LaboratorioGluon/Icaro/Modules/CamBoard/Doc/CameraBoard.md

# Camera Board

Tarjeta diseñada para capturar, envíar y guardar imágenes.
