LaboratorioGluon/Icaro/Modules/SensorBoard/Doc/SensorBoard.md

# Sensor Board

Tarjeta encargada de recoger datos de los sensores y telemetría

## Funcionalidad

## Diseño
