LaboratorioGluon/Icaro/Docs/Images/IMS.png

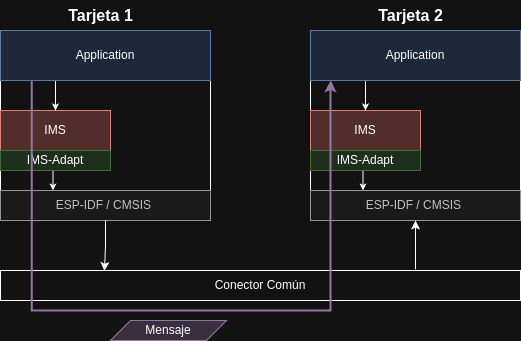
Docs/Images/IMS.png
