LaboratorioGluon/Icaro/Docs/Images/Parche_Icaro_alpha.png

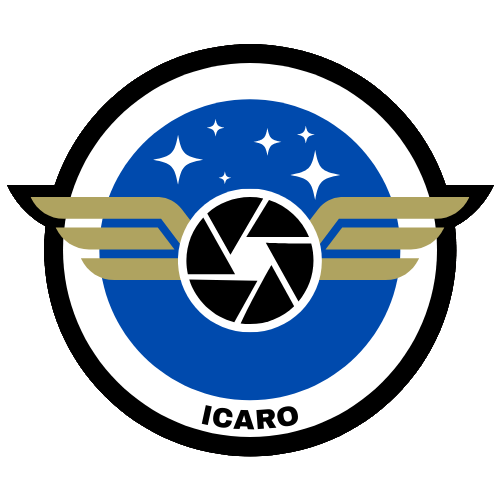
Docs/Images/Parche_Icaro_alpha.png
