LaboratorioGluon/Icaro/Modules/SupplyBoard/PCB/SupplyBoard/SupplyBoard.pdf

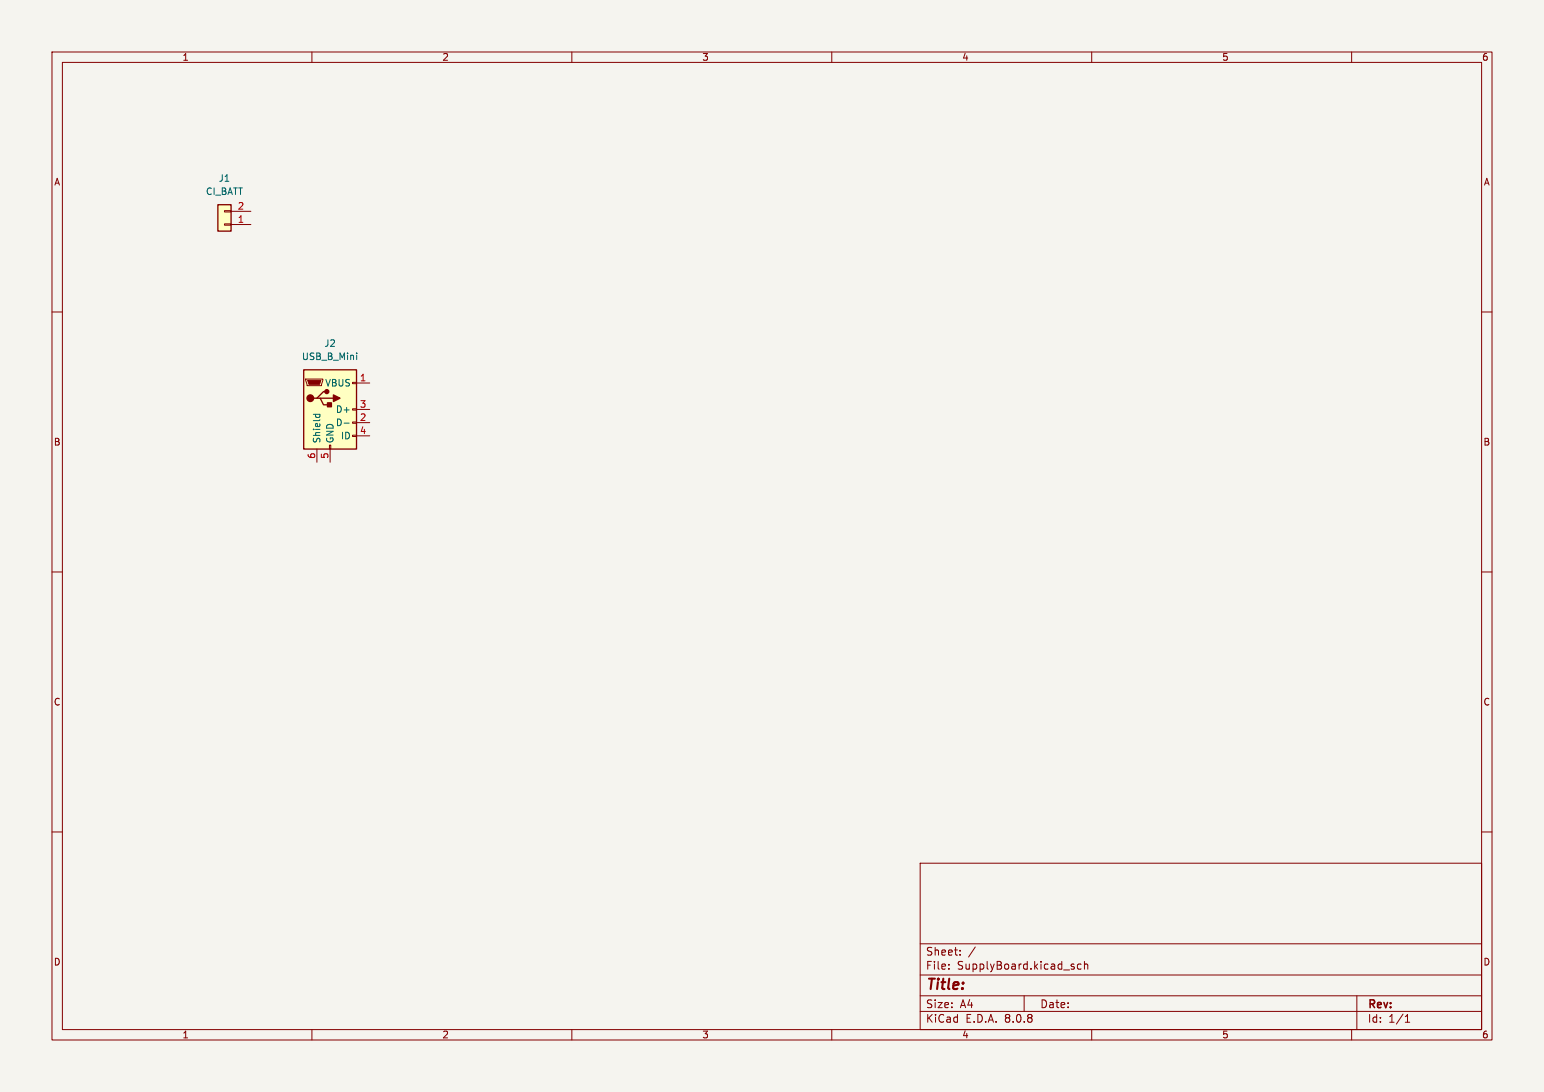
[picture p4: page 1]

Id: 1/1 Title: File: SupplyBoard.kicad_sch Sheet: /
