LaboratorioGluon/Icaro/Modules/SupplyBoard/PCB/SupplyBoard/SupplyBoard.kicad_pcb

## KiCad design Modules/SupplyBoard/PCB/SupplyBoard/SupplyBoard.kicad_pcb (2025-01-26)

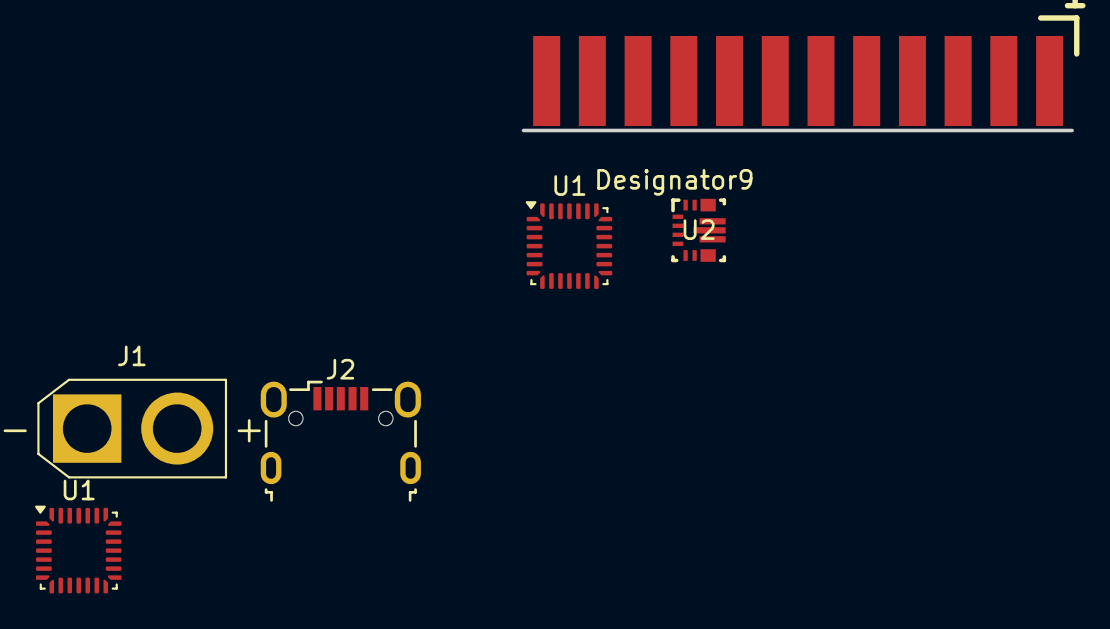
[picture p5: board SupplyBoard.kicad_pcb from above]

Board: 2 copper layers, 6 parts (0 on the bottom side), 5 nets, no tracks yet.

Parts:
J1: CI_BATT; AMASS_XT30U-F_1x02_P5.0mm_Vertical
J2: USB_B_Mini; USB_Micro-B_Wuerth_629105150521
J3: CIO_MAIN_CONNECTOR; Connector_Icaro_Edge_tarjeta
U1, U1#2: STM32L031G6Ux; QFN-28_4x4mm_P0.5mm
U2: TPS63070; RNM0015A

Connections:
+3.3V: J3.6 (3V3), U1.1 (VDD)
/BATT_BYPASS: J3.1 (BYPASS), J3.2 (BYPASS)
/I2C0_SDA: J3.7 (SDA_0), J3.9 (SCL_0)
GND: J1.1, J3.3 (GND), J3.4 (GND), J3.15 (GND), J3.16 (GND), U1.16 (VSS), U1.28 (VSS)
unnamed: U1#2.16 (VSS), U1#2.28 (VSS)
