LaboratorioGluon/Icaro/(threads)

Thread 1 (2025-01-20):

Elegir conector para juntar las tarjetas.

LaboratorioGluon, 2025-01-20:
Hay que elegir un conector que nos permita apilar las tarjetas una encima de otra tipo sandwich.

Ejemplo: https://www.researchgate.net/figure/Standard-2U-CubeSat-diagram-CubeSats-are-small-scale-satellites-composed-of-several_fig1_331595385

Como aún no sabemos cuantos pines necesitamos, buscar la referencia para 8-10 pines

Necesario:
- Part number en lcsc
- Precio

sergivv, 2025-01-20:
Hola,
Yo pensé en estos:
LCSC Part: C169817
Precio: 0,84$

En lugar de montar las placas en sandwich como en la foto, se haría una placa con distintos "puertos" (como una placa base del ordenador) y se pincharían ahí los módulos.
En las placas auxiliares se puede poner un sistema de tuercas para amarrar bien la placa a la base. (a ver si consigo una foto).
También en las placas auxiliares y en la que lleve el ESP32 se pude interponer un minipuente en cada pin para activar solo los que necesitas (con un puente de estaño)

LaboratorioGluon, 2025-01-20:
Entiendo que dices algo como esto: https://www.researchgate.net/figure/The-picture-above-shows-an-early-version-of-the-backplane-with-the-OBC-mounted_fig4_269389876

Se usa mucho en aviónica y tal, el tener como una placa con los conectores, y el resto se enganchan a ella. De hecho podríamos usar conectores PCIe 1x o parecidos. He encontrado este:

C5173289
0.34€/u
https://www.lcsc.com/product-detail/Edgeboard-Connectors_WingTAT-ED10BGFBK_C5173289.html

La única pega por decir algo, es que las placas no se puede reutilizar solas. Si ponemos un pinheader normal, es más fácil utilizar la placa de sensores en otro proyecto. Pero aún así, me mola la idea

Algo como esto, aprox... muy aprox
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

sergivv, 2025-01-20:
Efectivamente me refería a como está en el enlace. Pero a mayores se podría poner unos tornillos que aseguren la placa.

Intentaré sacar una fotos a unas placas que hicieron en mi empresa, no lleva los pines como los que indique.
Lleva otros que son con muelle pero son carillos. Lo bueno es que en la placa base no lleva nada, solo contactos del cobre.

LaboratorioGluon, 2025-01-21:
Se usará McGyver en el lateral con pin header estándar de 2.54mm

Closed 2025-01-21.

Thread 2 (2025-01-20):

Elegir pinout del conector general para el tipo sandwich

LaboratorioGluon, 2025-01-20:
Hay que tener una idea de cómo organizamos el pinout del connector común a todas las tarjetas. Necesitamos que cualquier otra tarjeta se pueda pinchar encima, así que lo ideal sería que mínimo tuviera:

- Bypass (depende del conector 1 pin o varios para manejar más corriente)
- 5V (para 500mA)
- 3v3 (para 500mA)
- Un par de I2C/SPI
- Un UART?

Estaría bien también que se pudiera programar por el conector de alguna manera.

LaboratorioGluon, 2025-03-15:
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

Closed 2025-03-15.

Thread 3 (2025-01-20):

Sensores básicos internos.

LaboratorioGluon, 2025-01-20:
Elegir que sensores vamos a colocar en la tarjeta.

Mínimo:
- Temperatura
- Humedad
- Presión (barómetro)

sergivv, 2025-01-20:
Veo problemas para encontrar sensor de temperatura adecuado.
Los más comunes no tienen suficiente rango negativo. Por el momento el que tiene el mayor rango (negativo) es el ds18b20 que llega hasta los -55ºC pero viendo las sondas de hoy se alcanzaron temperaturas de -62,5ºC.

Buscando en lcsc hay varios que dicen ser hasta -70º pero después ves el datasheet y no pasan de -20º

sergivv, 2025-01-20:
Todo sería probar.
Otra opción sería montar una sonda pt100 que llegan hasta los -200º pero creo que también son carillas.

LaboratorioGluon, 2025-01-21:
Aquí aparecen unos sensores que marcan de -70: https://s.click.aliexpress.com/e/_olsfRwZ
Son PT100, habría que preparar el circuito de adaptación a los sensores.

Prediktor93, 2025-01-24:
En LCSC hay algunos sensores de temperatura PT100 que llegan hasta los -70º, como por ejemplo este:
https://www.lcsc.com/product-detail/Temperature-Sensors_YAGEO-32208548_C17639042.html
He metido este porque con estos rangos de temperatura parece que solo hay dos frabricantes, Mysentech y este, y este es el unico que tenia los datasheets en ingles.

Otra cosa a tener en cuenta, es que el sensor no deberia ir montado sobre la placa, si no con una sonda al exterior, si queremos una lectura real, ya que con el aislante del corcho y el calor de la electronica la lectura va a ser loca. Algo como esto:

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

LaboratorioGluon, 2025-01-24:
El que has pasado @Prediktor93 está out of stock :(

Prediktor93, 2025-01-24:
Pues tocara si no jugarsela con el dataset en chino con los de la otra marca
https://www.lcsc.com/product-detail/Temperature-Sensors_Mysentech-M117P_C5155921.html

david-oltra, 2025-01-24:
Mysentech M1820P
https://www.lcsc.com/product-detail/Temperature-Sensors_Mysentech-M1820P_C3025191.html

Se supone que llega a -70 aunque el datasheet en chino no ayuda...

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

sergivv, 2025-01-24:
Lo que mosquea un poco es que miras el datasheet y no aparecen los -70 grados por ningún lado.

david-oltra, 2025-01-24:
> Lo que mosquea un poco es que miras el datasheet y no aparecen los -70 grados por ningún lado.

En la imagen que he puesto pone un error de ±0.5ºc en el rango de -70 a -30. Poco mas he visto que haga referencia a -70.

LaboratorioGluon, 2025-01-26:
Sensores básicos:
Internos:
- BME280 (Temperatura, humedad y presión)
- LM20 (Temperatura PCB)
- GPS

Inter despegado:
 - [Opcional] PT100.

Externos:
- PT100

Closed 2025-01-26.

Thread 4 (2025-01-20):

Definir sistema de mensajes entre tarjetas.

LaboratorioGluon, 2025-01-20:
Hay que implementar una librería general a todas las tarjetas para la comunicación entre ellas. Por comodidad diría que un TLV es más que suficiente.

Cada tarjeta tendría su lista de mensajes que puede recibir y lo que respondería.

Thread 10 (2025-01-21):

Supply Board - Diseño general

LaboratorioGluon, 2025-01-21:
Hacer un diseño general con todos los componentes:
- Lista de componentes
- Interconexión y protocolo usado
- Comprobación de que el uC tiene los pines disponibles.

LaboratorioGluon, 2025-01-25:
Componentes elegidos:
| Item | Nombre | LCSC | Precio | Desc |
|-|-|-|-|-|
| Buck-boost | TPS63070RNMR | C109322 | 0.35€ | Conversor de LIPO a 5v/3v3 |
| Procesador | STM32L031 | C96514 | 0.94 € | Procesador principal |

Closed 2025-03-15.

Thread 9 (2025-01-21):

Sensor Board - Diseño general

LaboratorioGluon, 2025-01-21:
Hacer un diseño general con todos los componentes:
- Lista de componentes
- Interconexión y protocolo usado
- Comprobación de que el uC tiene los pines disponibles.

Closed 2025-03-15.

Thread 13 (2025-01-24):

GPS

david-oltra, 2025-01-24:
He pedido este para probar
BZGNSS BZ-251 GPS
https://es.aliexpress.com/item/1005008022472453.html

Usa para el GPS el u-blox M10050 (ten generation chip)
GPSL,GLONASS,BDS,GALILEO,SBAS,QZSS

Tambien lleva incorporado Compass: QMC5883

Thread 17 (2025-01-26):

Interfaz PT100

LaboratorioGluon, 2025-01-26:

LaboratorioGluon, 2025-01-26:
More info: https://www.bing.com/images/search?id=6F6811C437854785371A259ED797D29048ADF781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

LaboratorioGluon, 2025-03-15:
Diseño cerrado en la SensorBoard

Closed 2025-03-15.

Thread 27 (2025-03-18):

Añadir una licencia al proyecto para clarificar su uso

Supersonic2510, 2025-03-18:
He notado que el proyecto no cuenta con un archivo de licencia. Sin una licencia explícita, el código está protegido por derechos de autor por defecto, lo que limita su uso y contribución por parte de la comunidad. Recomiendo considerar la adopción de la Licencia Pública General de GNU versión 3.0 (GPL-3.0) debido a sus beneficios:

- **Garantiza que el software y sus derivados permanezcan libres y abiertos**
- **Permite el uso, estudio, modificación y distribución del código**
- **Fomenta una comunidad de colaboración y mejora continua**

Enlace a la licencia: [Licencia GPL-3.0](https://www.gnu.org/licenses/gpl-3.0.html)

Closed 2025-03-23.

Thread 34 (2025-06-08):

Directo del martes 10 de junio.

LaboratorioGluon, 2025-06-08:
-> Añadir temperaturas de los uC.
-> Añadir un Id al mensaje que se incremente para saber si hemos perdido alguno.
- Enviar los diferentes mensajes MAVLink,
- Reducir tiempo entre mensajes del LoRa
