LaboratorioGluon/Icaro/(commit log)

2025-01-21 [SupplyBoard] Initialize Kicad Project
    [SupplyBoard.kicad_pcb, SupplyBoard.kicad_sch]
2025-01-24 Added Icaro main connector and other footprints
2025-01-24 Supply board added common connector
    [SupplyBoard.kicad_pcb, SupplyBoard.kicad_sch]
2025-01-25 [Supply Board] Creados subesquemas
    [LipoTo3v.kicad_sch, LipoTo5v.kicad_sch, SupplyBoard.kicad_sch, controlador.kicad_sch]
2025-01-26 Added footprints for supply board components
2025-01-26 Lipo to 3v3 circuit added
    [LipoTo3v.kicad_sch, LipoTo5v.kicad_sch, SupplyBoard.kicad_pcb, SupplyBoard.kicad_sch]
2025-01-26 Changed documentation and added LCSC to buck converter
    [LipoTo3v.kicad_sch]
